jvegaf/toshiba_air_cond/pcb/airpcb_smd/airpcb_smd.kicad_pcb

## KiCad design pcb/airpcb_smd/airpcb_smd.kicad_pcb (2022-03-31)

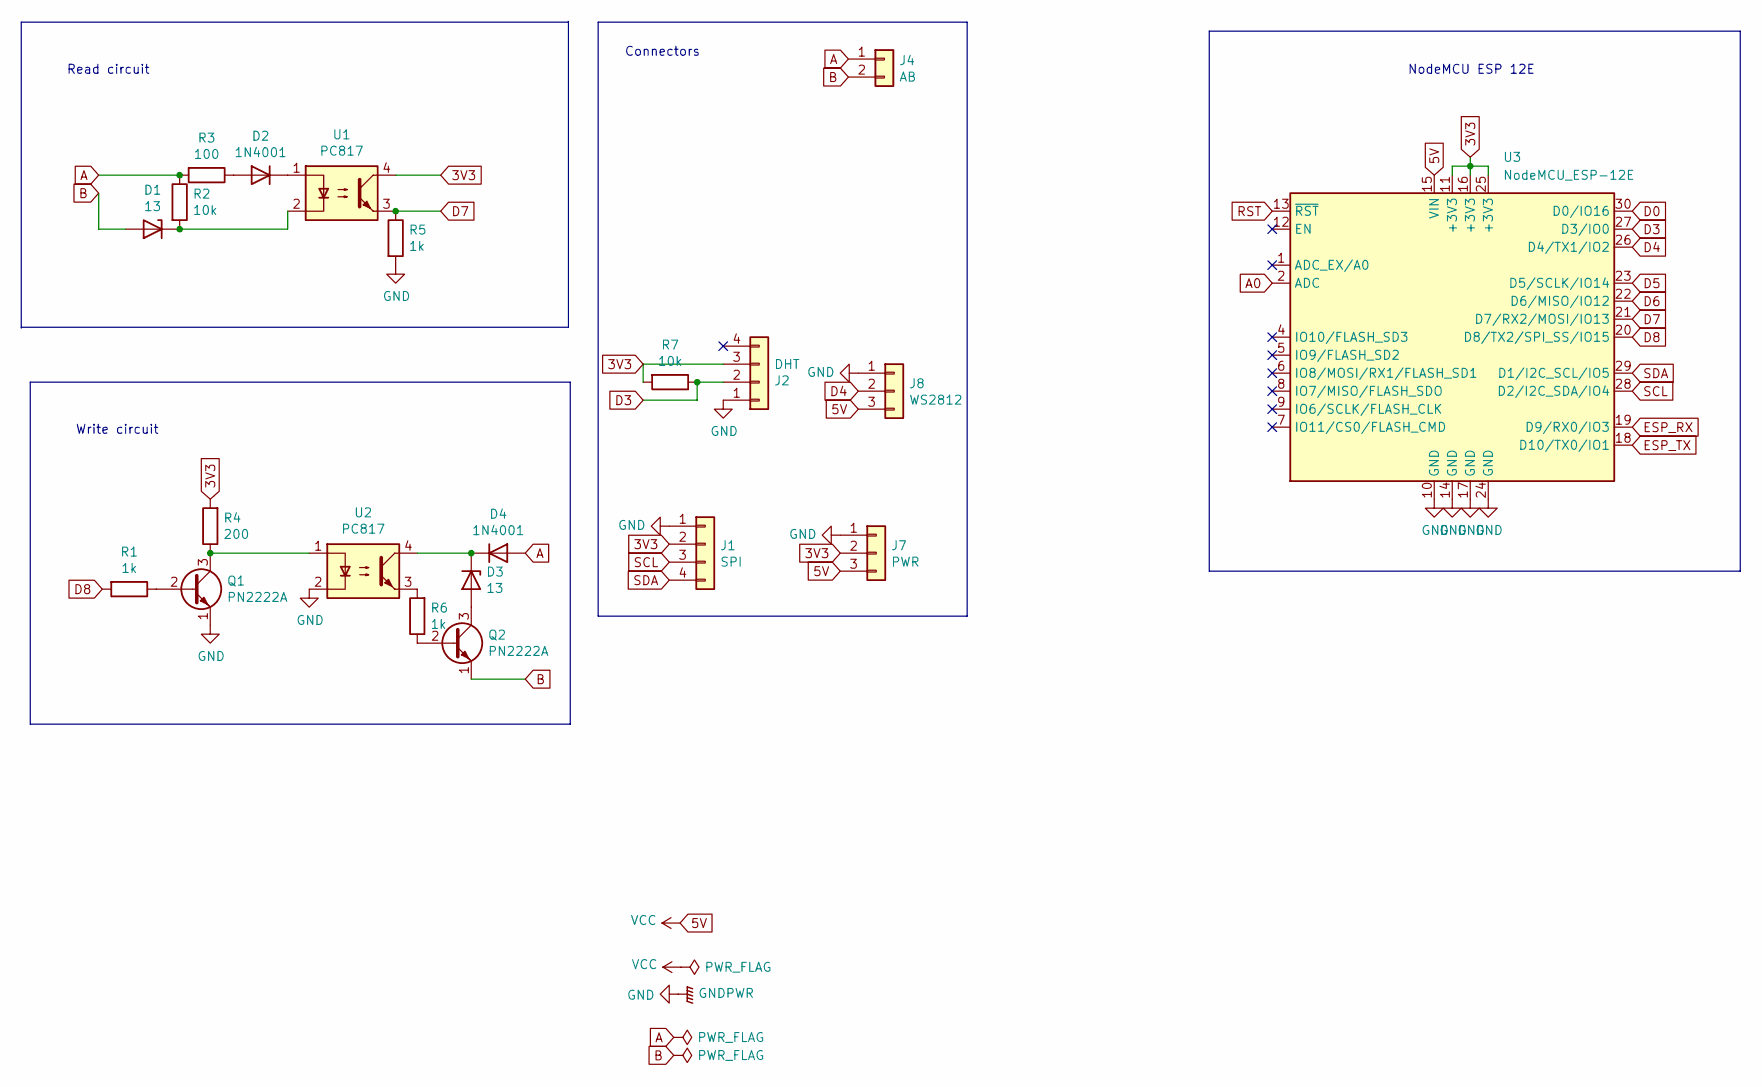
[picture p1: schematic airpcb_smd.kicad_sch, Toshiba AB Wifi Controller]

Parts:
D1, D3: 13; D_MiniMELF_Handsoldering
D2, D4: 1N4001; D_SMA
J1: SPI; PinSocket_1x04_P2.54mm_Vertical
J2: DHT; PinSocket_1x04_P2.54mm_Vertical
J4: AB; PinSocket_1x02_P2.54mm_Vertical
J7: PWR; PinSocket_1x03_P2.54mm_Vertical
J8: WS2812; PinSocket_1x03_P2.54mm_Vertical
Q1, Q2: PN2222A; SOT-23_Reverse_Handsoldering
R1, R5, R6: 1k; R_0805_2012Metric
R2, R7: 10k; R_0805_2012Metric
R3: 100; R_0805_2012Metric
R4: 200; R_0805_2012Metric
U1, U2: PC817; DIP-4_W7.62mm
U3: NodeMCU_ESP-12E; NodeMCU_ESP-12E_WithMountingHoles

Connections:
3V3: J1.2, J2.3, J7.2, R4.2, R7.2, U1.4, U3.11 (+3V3), U3.16 (+3V3), U3.25 (+3V3)
5V: J7.3, J8.3, U3.15 (VIN)
A: D4.2 (A), J4.1, R2.1, R3.2
A0: U3.2 (ADC)
B: D1.2 (A), J4.2, Q2.1 (E)
D0: U3.30 (D0/IO16)
D3: J2.2, R7.1, U3.27 (D3/IO0)
D4: J8.2, U3.26 (D4/TX1/IO2)
D5: U3.23 (D5/SCLK/IO14)
D6: U3.22 (D6/MISO/IO12)
D7: R5.1, U1.3, U3.21 (D7/RX2/MOSI/IO13)
D8: R1.2, U3.20 (D8/TX2/SPI_SS/IO15)
ESP_RX: U3.19 (D9/RX0/IO3)
ESP_TX: U3.18 (D10/TX0/IO1)
GND: J1.1, J2.1, J7.1, J8.1, Q1.1 (E), R5.2, U2.2, U3.10 (GND), U3.14 (GND), U3.17 (GND), U3.24 (GND)
unnamed: D1.1 (K), R2.2, U1.2
unnamed: D2.1 (K), U1.1
unnamed: D2.2 (A), R3.1
unnamed: D3.1 (K), D4.1 (K), U2.4
unnamed: D3.2 (A), Q2.3 (C)
unnamed: Q1.2 (B), R1.1
unnamed: Q1.3 (C), R4.1, U2.1
unnamed: Q2.2 (B), R6.1
unnamed: R6.2, U2.3
RST: U3.13 (~RST)
SCL: J1.3, U3.28 (D2/I2C_SDA/IO4)
SDA: J1.4, U3.29 (D1/I2C_SCL/IO5)

Notes on the sheet:
Connectors
Write circuit
NodeMCU ESP 12E
Read circuit

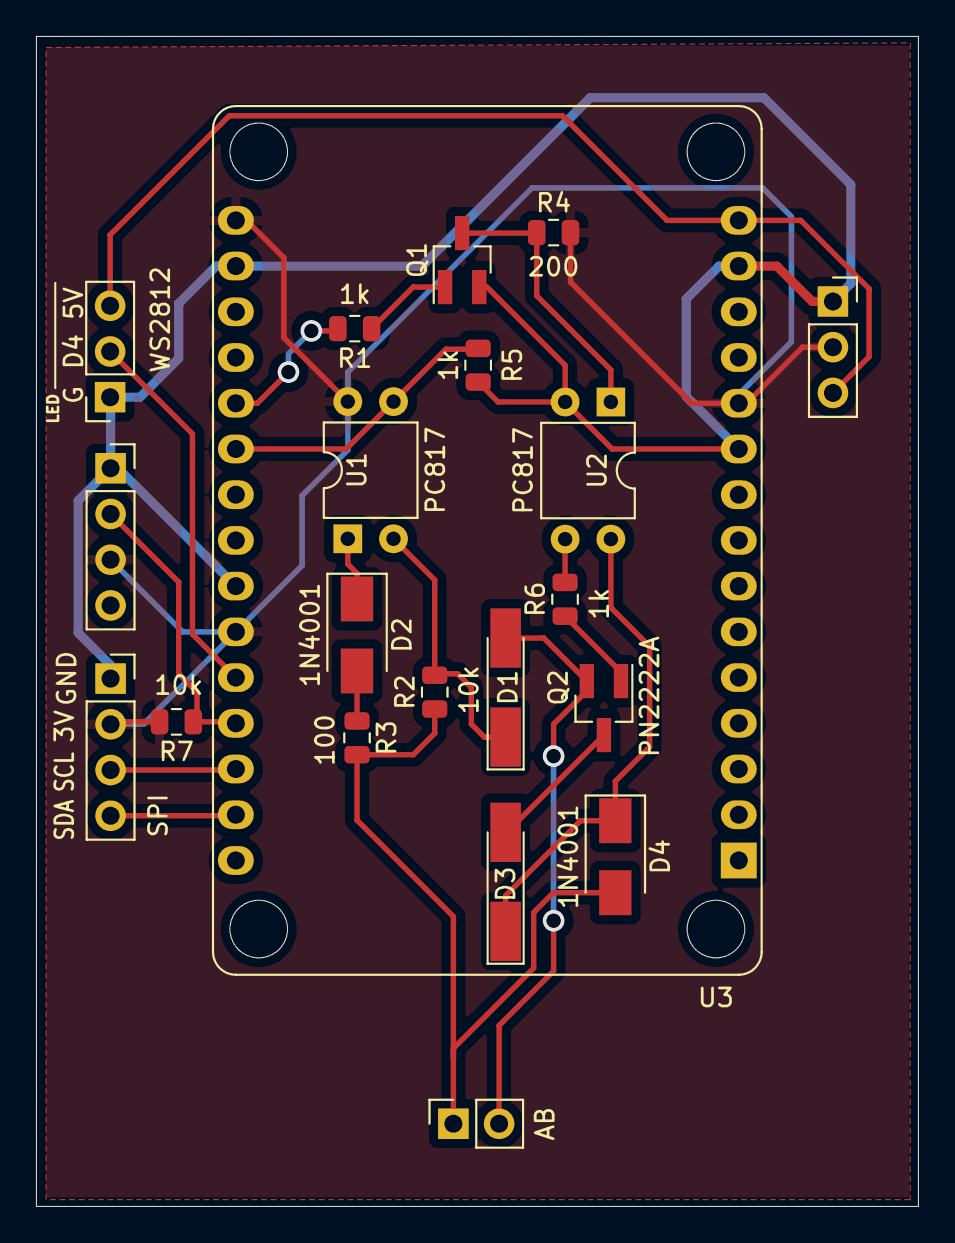
[picture p2: board airpcb_smd.kicad_pcb from above]

Board: 2 copper layers, 49.0 x 65.0 mm, 21 parts (0 on the bottom side), 20 nets.
