jvegaf/toshiba_air_cond/Code/ToshibaAir/src/config.h

#pragma once
#include <Arduino.h>

static const uint8_t MAX_LOG_DATA = 72; //store up to 72 readings in a circular buffer

// #define USE_BMP //if BMP sensor installed
#define USE_DHT //in DHT sensor installed

#define USE_ASYNC

//wifi credentials, no needed because now we use WiFiManager
const char *w_ssid = "YOURWIFI";
const char *w_passwd = "YOURPASSPWD";

//Over the air credentials
const char *OTAName = "air";           // A name and a password for the OTA service
const char *OTAPassword = "esp8266";

const char* mdnsName = "air"; // Domain name for the mDNS responder. Just connect to air.local
const char compile_date[] = __DATE__ " " __TIME__;


#ifndef LED_BUILTIN
  #define LED_BUILTIN 13 // ESP32 DOES NOT DEFINE LED_BUILTIN
#endif

const int LED = LED_BUILTIN;

const int DHTPin = D3;
#define DHTTYPE DHT22   // DHT 22  (AM2302), AM2321

#define RESET_MODE_PIN D4  //button to enter into wifi configuration

static const uint16_t ONE_SECOND = 1000;


//  
