jvegaf/toshiba_air_cond/Code/ToshibaAir/src/MySimpleTimer.h

#pragma once
#include <Arduino.h>

class MySimpleTimer {
    uint64_t _start;
    int _interval;
    bool _enabled = false;
    int _unit = 60 * 1000;
    bool _repeat = false;

  public:

    /// Constructor, that initialize timer
    /// \param interval An interval in msec
    explicit MySimpleTimer(int interval = 0);

    /// Check if timer is ready
    /// \return True if is timer is ready
    bool isTime();

    /// Return pending time
    int pendingTime();

    /// Set the time interval
    /// \param interval An interval in msec
    void setInterval(int interval);

    /// Get interval
    int getInterval();

    /// Set unit
    void setUnit(int unit);

    /// Enable timer
    void enable();

    /// Disable timer
    void disable();

    /// is enabled?
    bool isEnabled();

    /// repeat
    void repeat();

    /// do not repeat
    void dontRepeat();

    /// Start tiner
    void start();
};
