jvegaf/toshiba_air_cond/(commit log)

2022-03-27 feat(pcb kicad project): update to v6 * migrated to kicad v6
    * added nodemcu symbols & footprints ( nodemcu project lib )
    [airpcb_smd.kicad_pcb, airpcb_smd.kicad_sch]
2022-04-07 fix all compiler warnings
    [MySimpleTimer.hpp, ToshibaAir.ino, config.h, process_request.hpp, toshiba_serial.hpp]
